solomonbstoner/Ridiculously-simple-Attiny85-AM-radio-transmitter/pics_and_videos/attiny85_datasheet_sec6.2_pg25_clock_sources.png

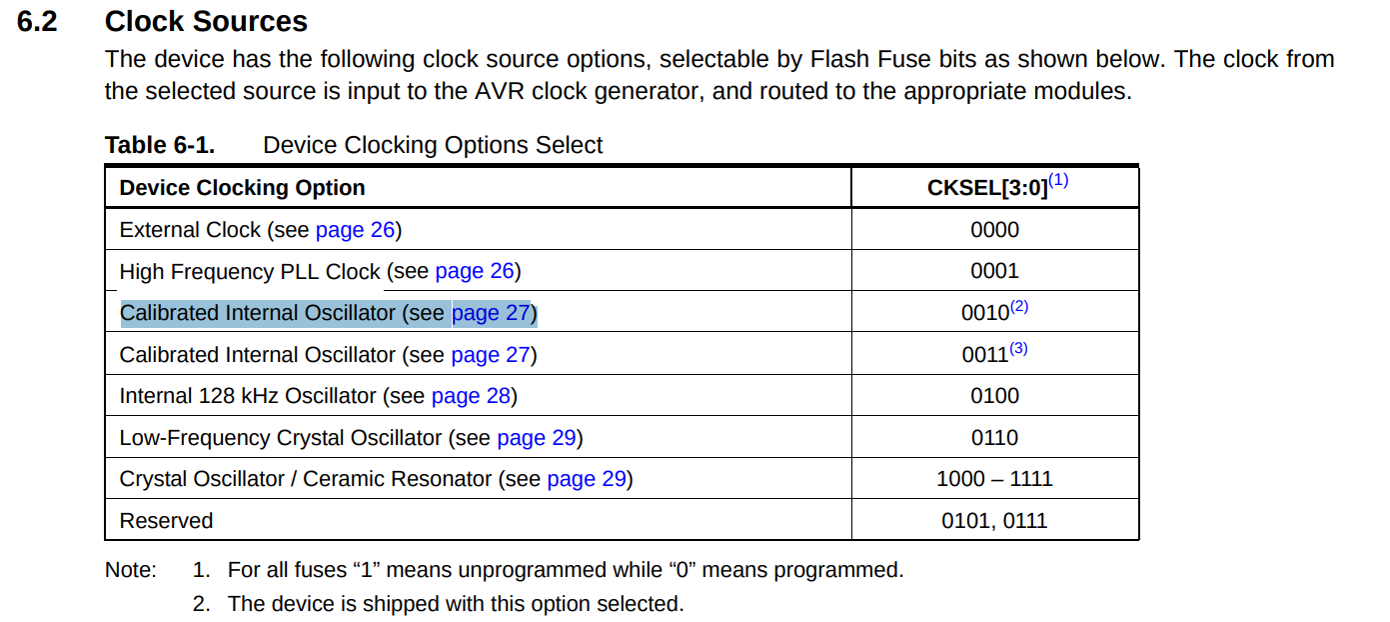
pics_and_videos/attiny85_datasheet_sec6.2_pg25_clock_sources.png
