solomonbstoner/Ridiculously-simple-Attiny85-AM-radio-transmitter/pics_and_videos/attiny85_datasheet_sec6.4_pg31_clock_output_buffer.png

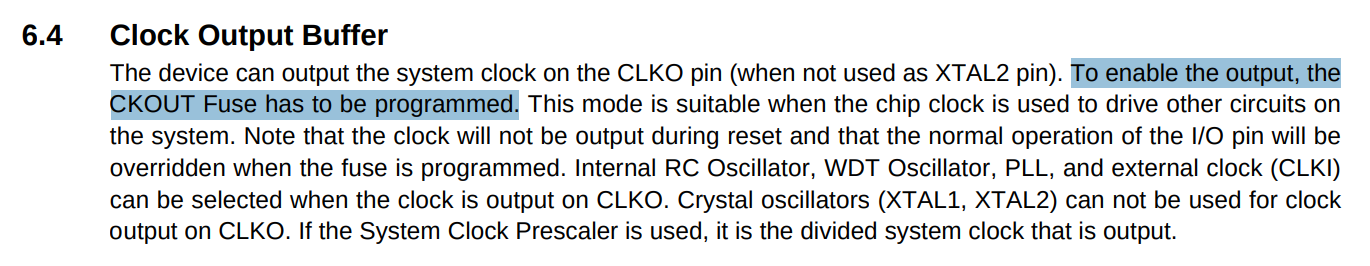
pics_and_videos/attiny85_datasheet_sec6.4_pg31_clock_output_buffer.png
