solomonbstoner/Ridiculously-simple-Attiny85-AM-radio-transmitter/pics_and_videos/attiny85_osc_output_from_clko_pin_1mhz.jpg

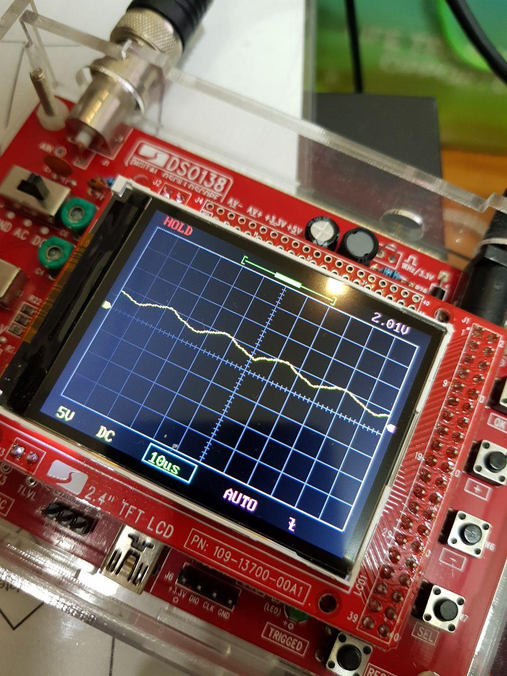
pics_and_videos/attiny85_osc_output_from_clko_pin_1mhz.jpg
