solomonbstoner/Ridiculously-simple-Attiny85-AM-radio-transmitter/pics_and_videos/attiny85_datasheet_sec6.2.3_pg27_calibrated_internal_oscillator.png

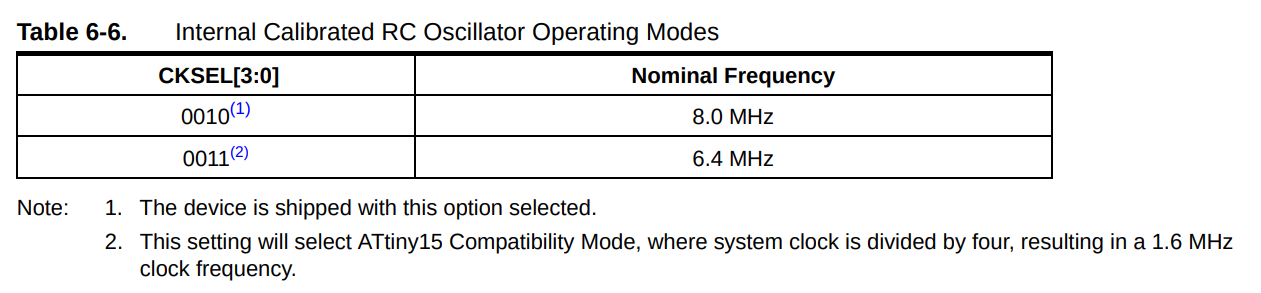
pics_and_videos/attiny85_datasheet_sec6.2.3_pg27_calibrated_internal_oscillator.png
